seon46/ems-vr-locomotion/hardware/carrier_board/openTENS_carrier.kicad_pcb

## KiCad design hardware/carrier_board/openTENS_carrier.kicad_pcb (2026-11-09)

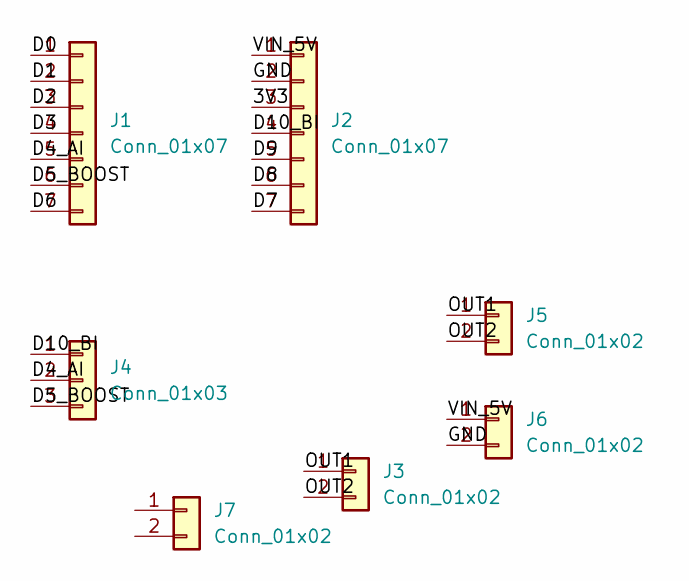
[picture p1: schematic openTENS_carrier.kicad_sch]

Parts:
J1, J2: Conn_01x07; PinHeader_1x07_P2.54mm_Vertical
J3, J5, J6, J7: Conn_01x02; PinHeader_1x02_P2.54mm_Vertical
J4: Conn_01x03; PinHeader_1x03_P2.54mm_Vertical

Connections:
/3V3: J2.3
/D0: J1.1
/D1: J1.2
/D2: J1.3
/D3: J1.4
/D4_AI: J1.5, J4.2
/D5_BOOST: J1.6, J4.3
/D6: J1.7
/D7: J2.7
/D8: J2.6
/D9: J2.5
/D10_BI: J2.4, J4.1
/GND: J2.2, J6.2
/OUT1: J3.1, J5.1
/OUT2: J3.2, J5.2
/VIN_5V: J2.1, J6.1

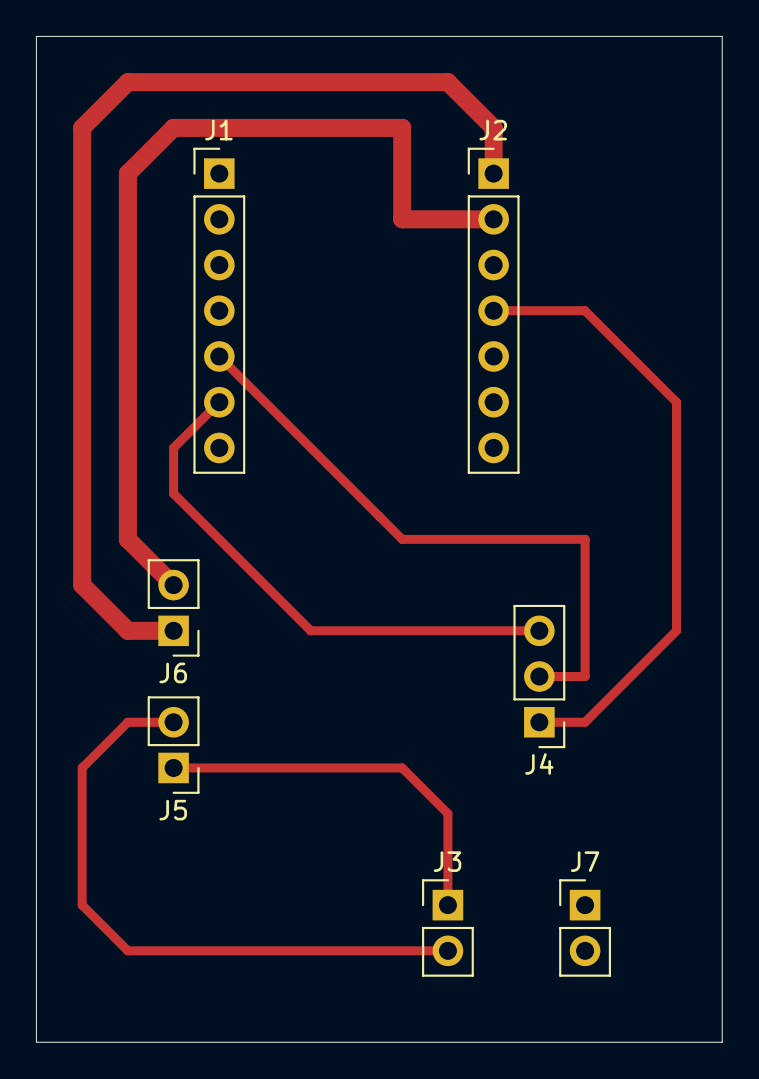
[picture p2: board openTENS_carrier.kicad_pcb from above]

Board: 2 copper layers, 38.1 x 55.9 mm, 7 parts (0 on the bottom side), 7 nets.
