seon46/ems-vr-locomotion/(commit log)

2026-10-27 Initial commit: research project structure and vibration firmware
    - README with research overview, system architecture, and references
    - 4-motor vibration firmware (ESP32 HUZZAH32 + IRLZ44N MOSFET)
    - Directory structure for firmware, hardware, and docs
    Claude-Session: https://claude.ai/code/session_01A4BZwFjnTmBKwQk1ngTxpr
    [vibration_4motor.ino]
2026-10-27 Add Unity scripts and UDP test tool
    Unity scripts for gait-synchronized EMS triggering system:
    - GaitTiming.cs: shared gait phase provider (heel strike phases from Mixamo Walking)
    - EMSTrigger.cs: Battye et al. (1966) muscle timing → UDP FIRE commands
    - FootstepAudio.cs: heel-strike-synced footstep audio with silence skipping
    - HeadFollow.cs: neck-pivot VR camera tracking with phase-synced head bob
    - GaitDiagnostics.cs: tool for measuring heel strike Normalized Time values
    Test tools:
    - udp_test_send.py: interactive/CLI UDP test sender for EMS channels
    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
2026-10-28 Rename Unity scripts to match C# class names
    Unity requires .cs filenames to exactly match their class names.
    - Walkinput.cs → WalkInput.cs
    - Vriktargetfollower.cs → VRIKTargetFollower.cs
    - Corridorgenerator.cs → CorridorGenerator.cs
    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
2026-11-09 Update README for clarity and additional details
    README.mdを現在の研究内容・ファイル構成に合わせて書き直し
2026-11-09 不要なファイルを削除
